gram-117/bella_revised/README.md

# bella

KICAD files + LTspice simulation for PMT driver circuit
tested and working
