gram-117/bella_revised/Schematics/bellamu.pdf

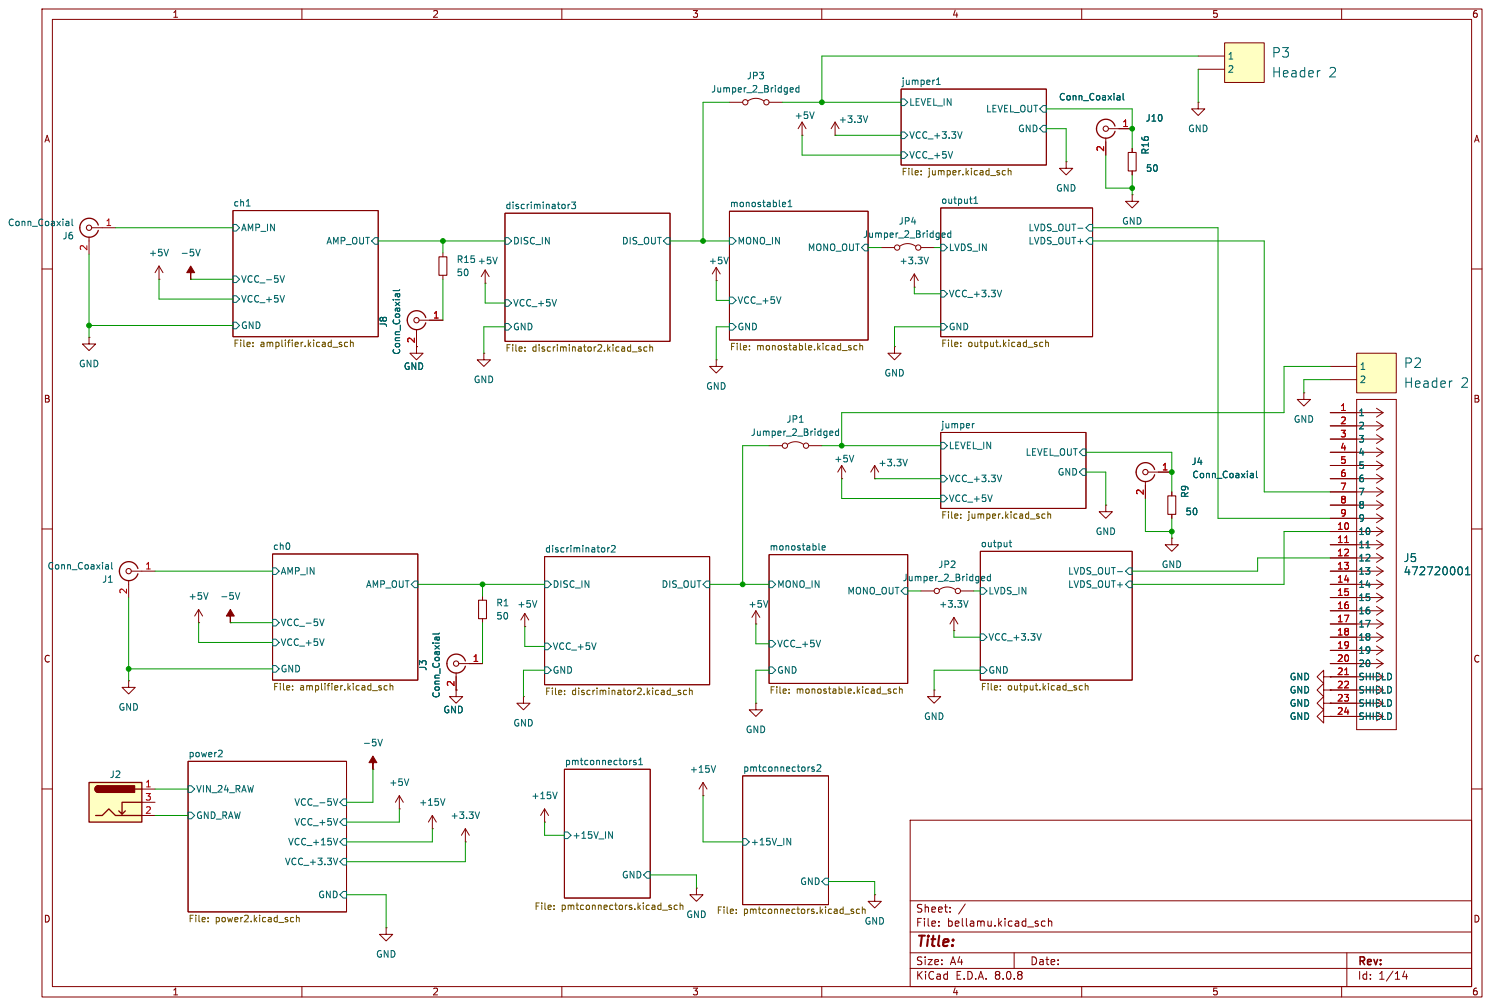
[picture p5: page 1]

20 20 SHIELD 21 SHIELD 22 SHIELD 23 SHIELD 24

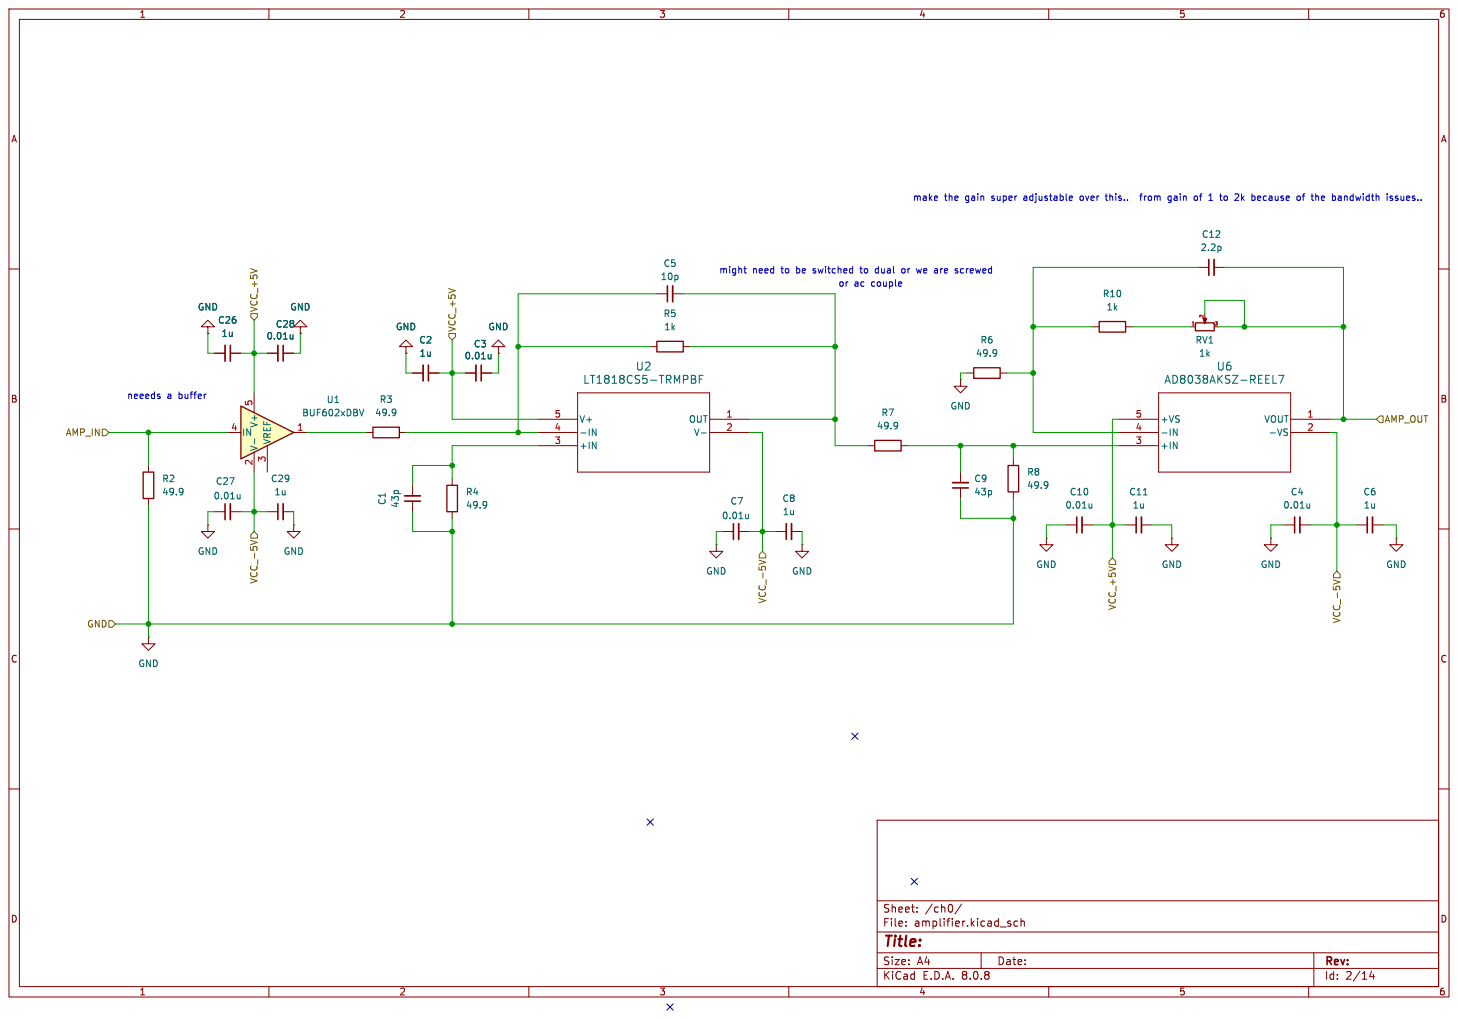
[picture p6: page 2]

might need to be switched to dual or we are screwed C3

Id: 2/14 Title: File: amplifier.kicad_sch Sheet: /ch0/

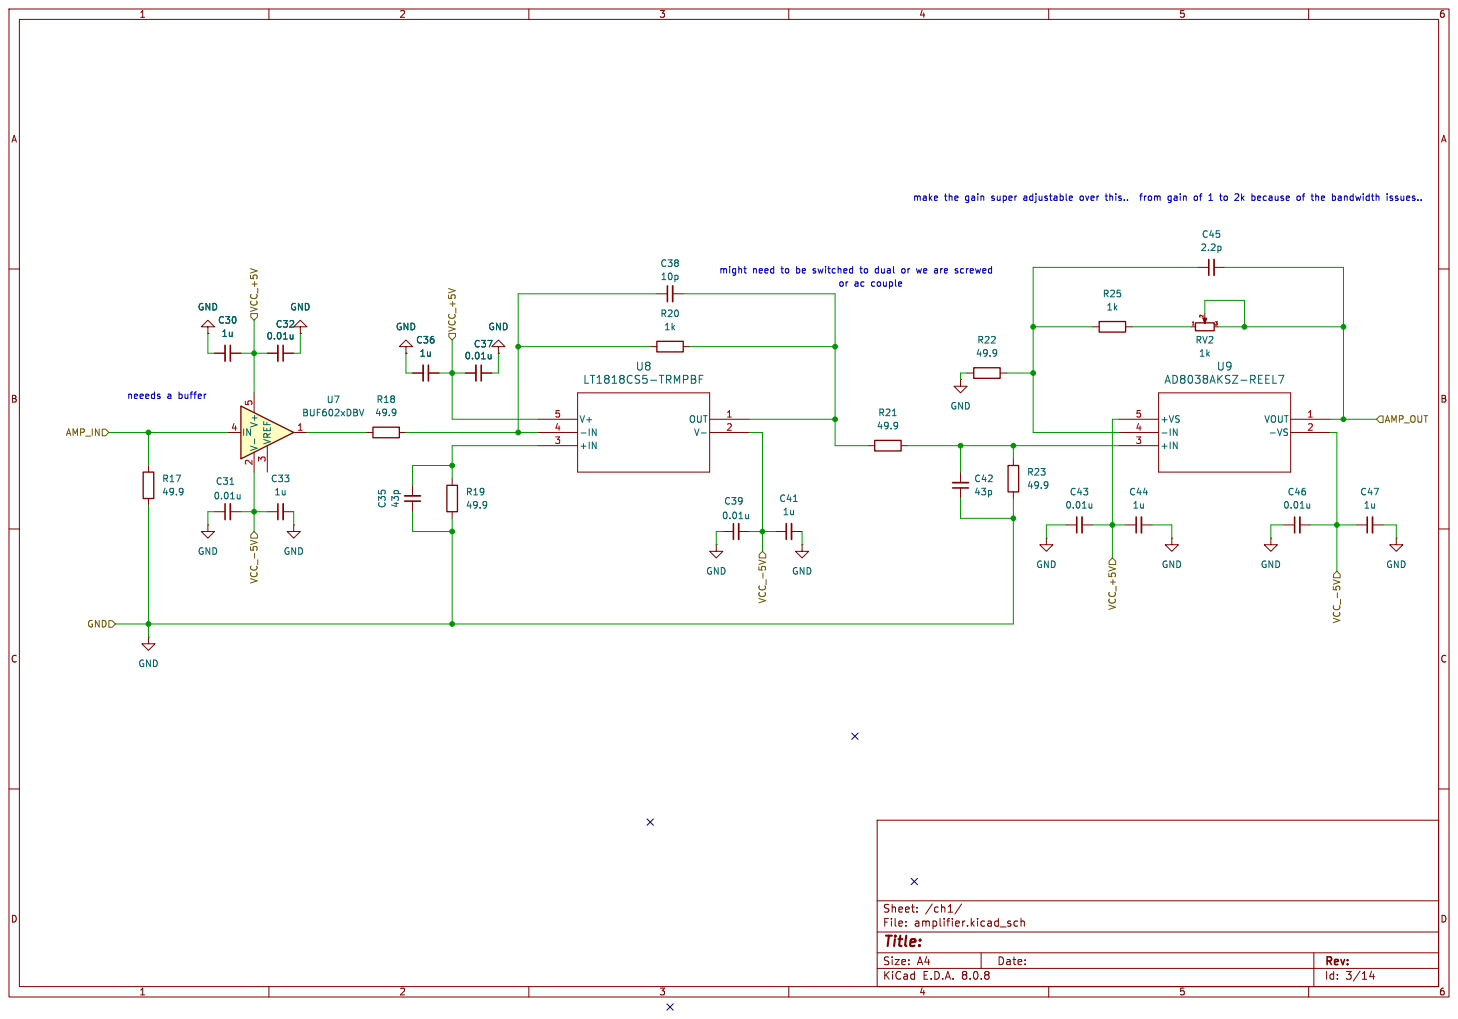
[picture p7: page 3]

might need to be switched to dual or we are screwed C37

Id: 3/14 Title: File: amplifier.kicad_sch Sheet: /ch1/

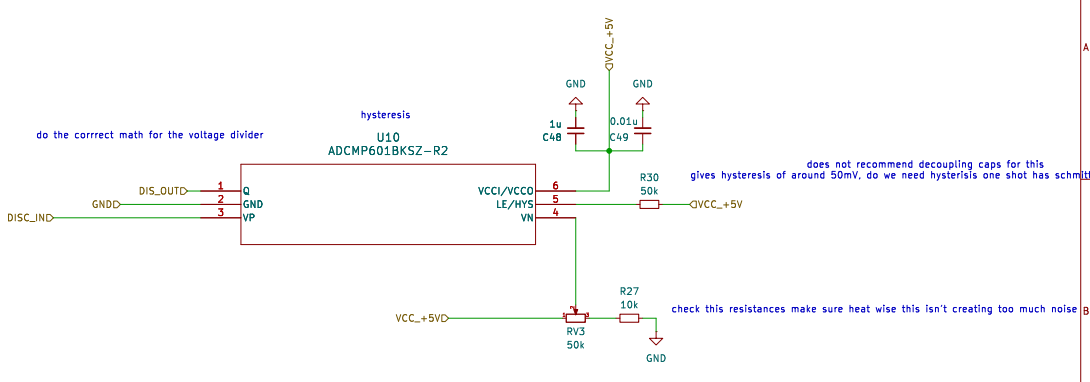
[picture p8: page 4]

Id: 4/14 Title: File: discriminator2.kicad_sch Sheet: /discriminator3/

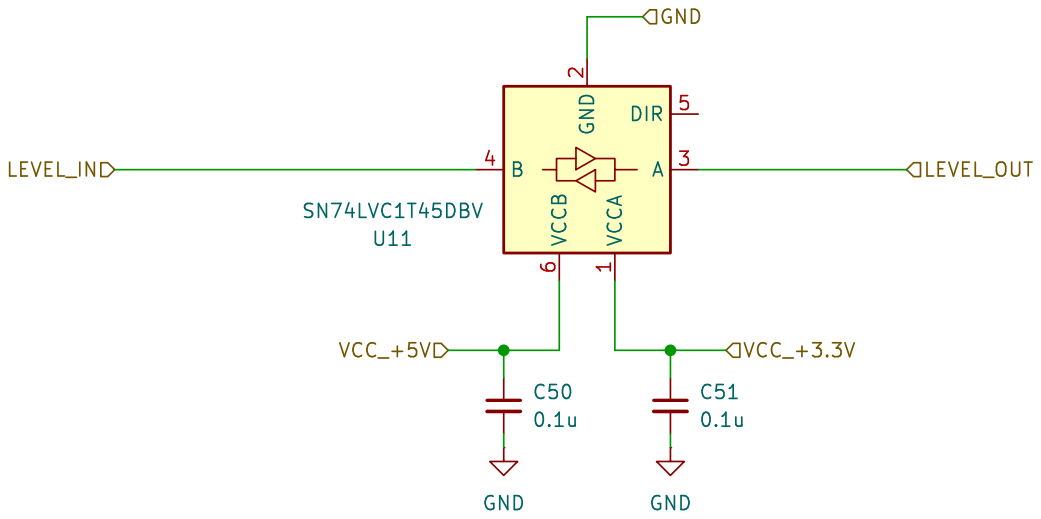
[picture p9: page 5]

Id: 5/14 Title: File: jumper.kicad_sch Sheet: /jumper1/ C51

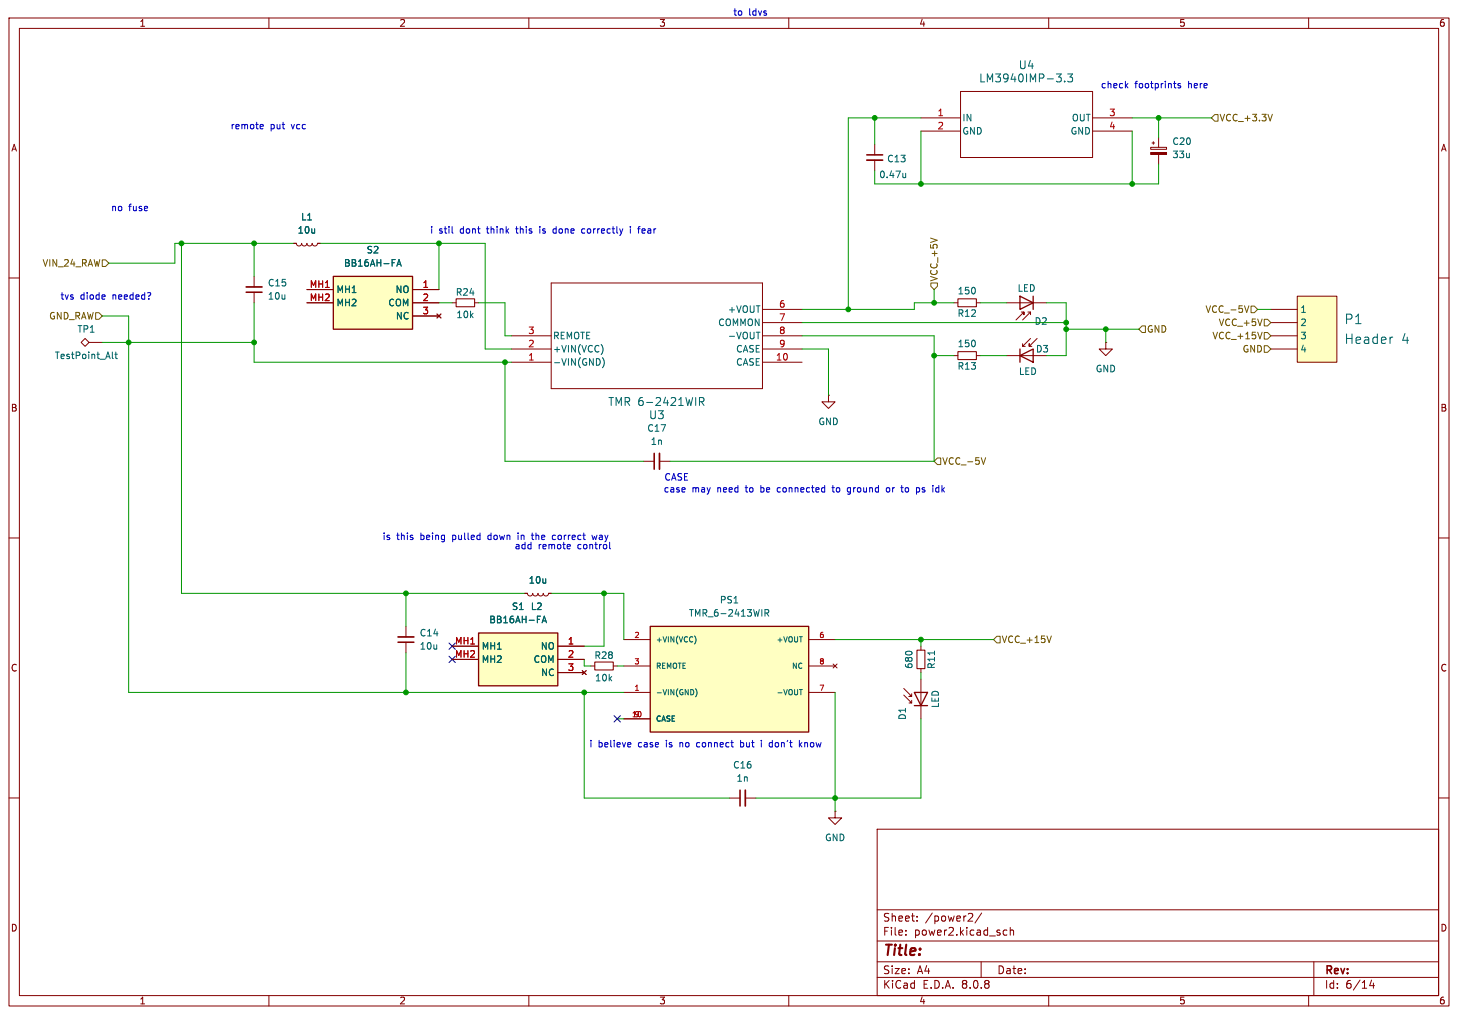
[picture p10: page 6]

remote put vcc no fuse

is this being pulled down in the correct way

i believe case is no connect but i don't know

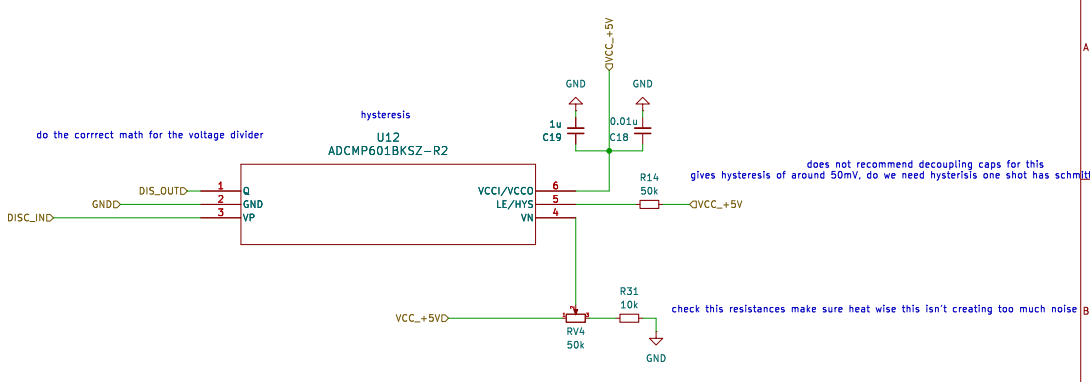
[picture p11: page 7]

Id: 7/14 Title: File: discriminator2.kicad_sch Sheet: /discriminator2/

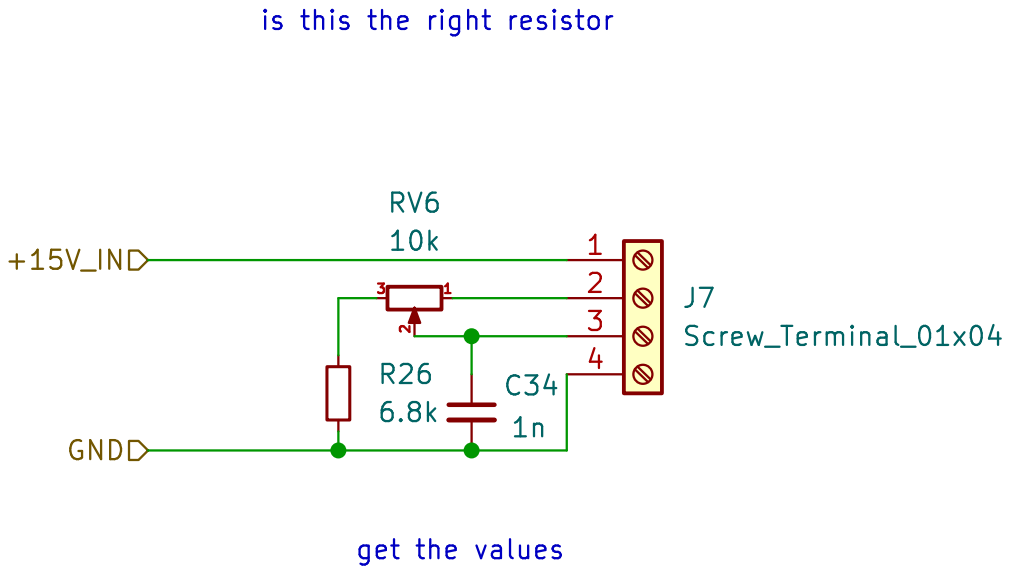
[picture p12: page 8]

is this the right resistor

Id: 8/14 Title: File: pmtconnectors.kicad_sch Sheet: /pmtconnectors1/

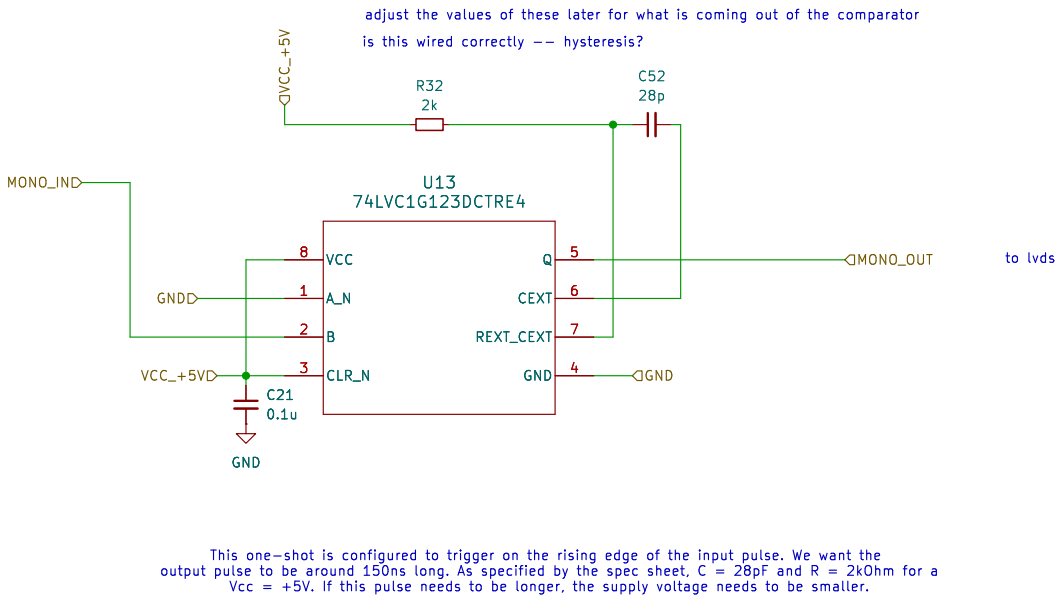
[picture p13: page 9]

adjust the values of these later for what is coming out of the comparator

Id: 9/14 Title: File: monostable.kicad_sch Sheet: /monostable/ GND

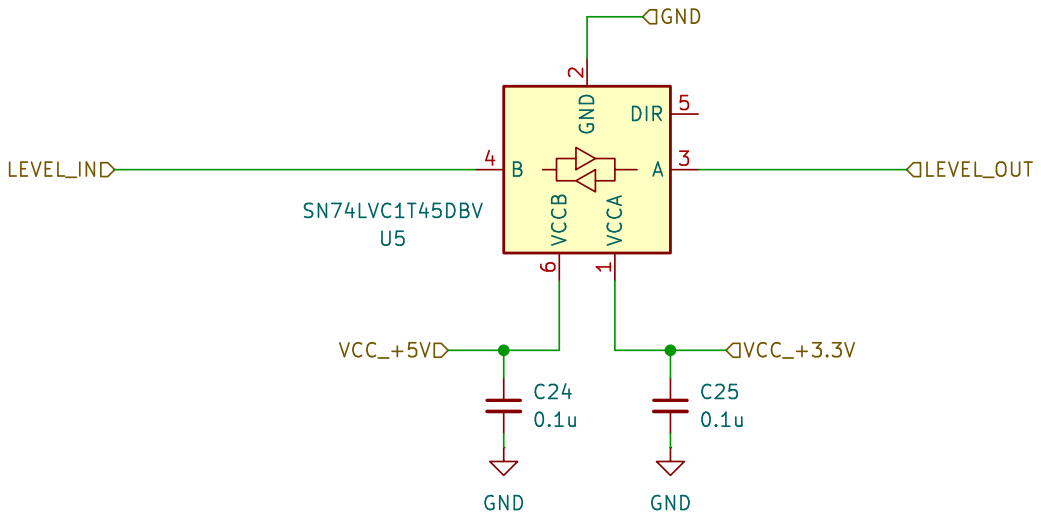
[picture p14: page 10]

Id: 9/14 Title: File: jumper.kicad_sch Sheet: /jumper/ C24
0.1u GND

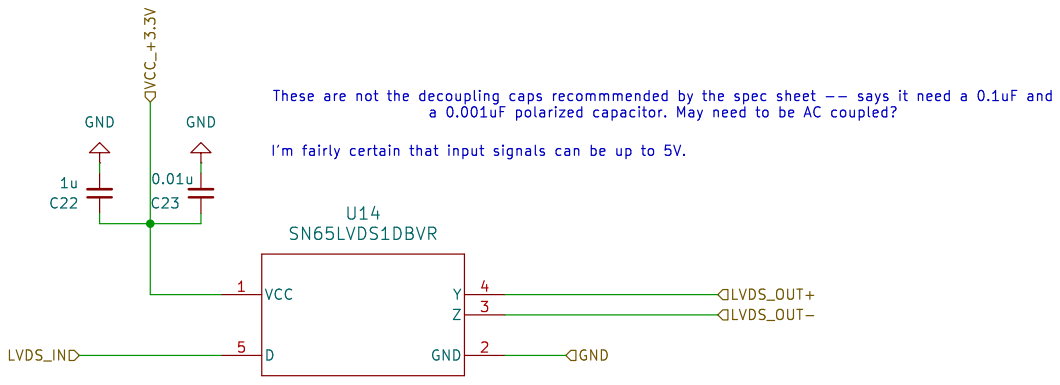
[picture p15: page 11]

Id: 10/14 Title: File: output.kicad_sch Sheet: /output/

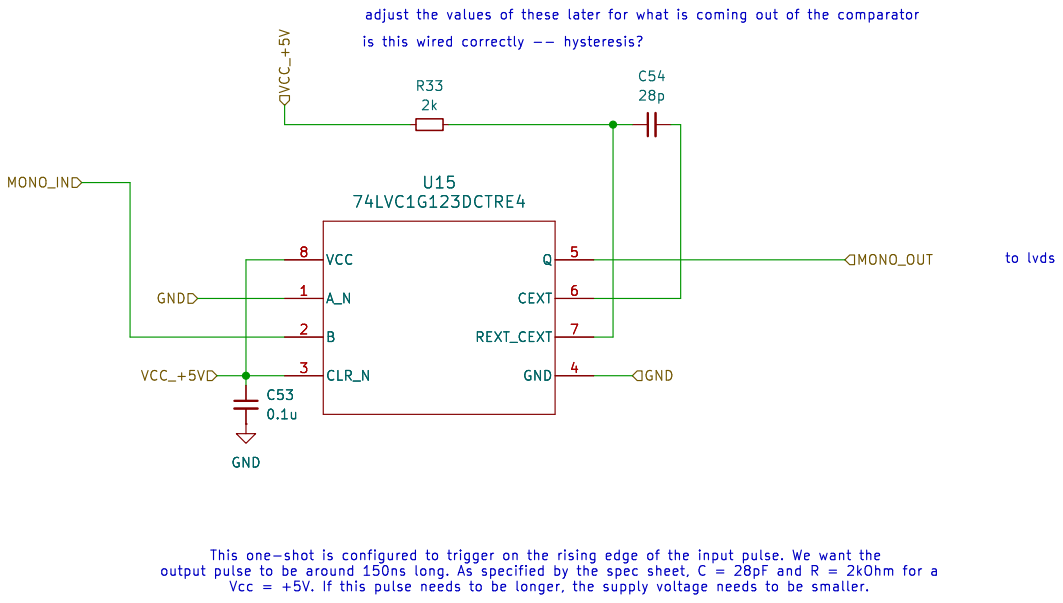
[picture p16: page 12]

adjust the values of these later for what is coming out of the comparator

Id: 11/14 Title: File: monostable.kicad_sch Sheet: /monostable1/ GND

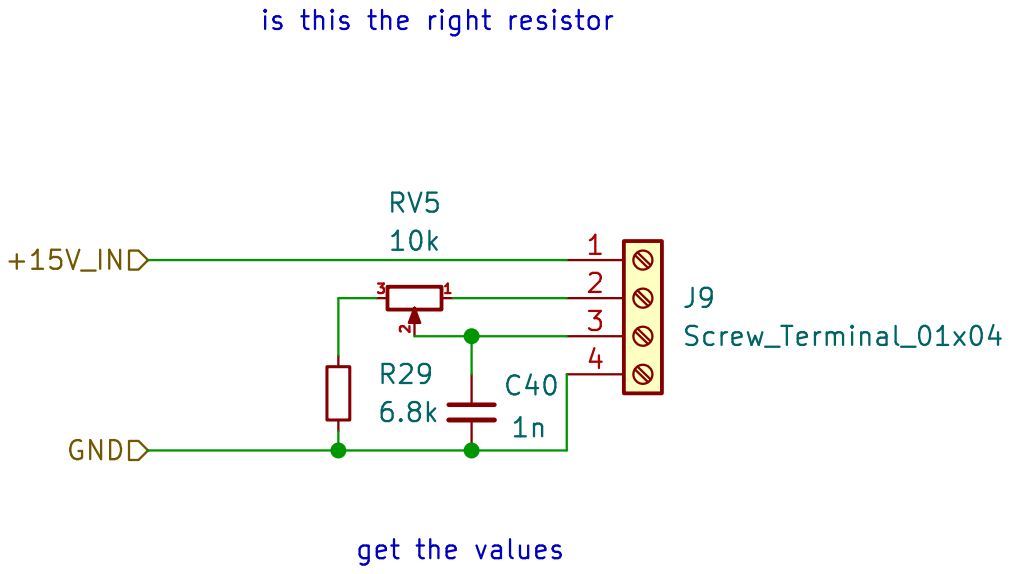
[picture p17: page 13]

is this the right resistor

Id: 12/14 Title: File: pmtconnectors.kicad_sch Sheet: /pmtconnectors2/

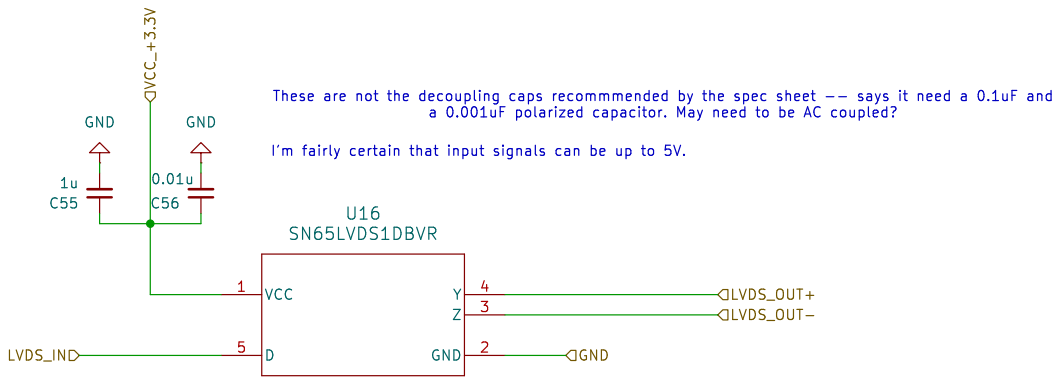
[picture p18: page 14]

Id: 13/14 Title: File: output.kicad_sch Sheet: /output1/
